Egor-G/router4x4g/README.md

4x M.2 LTE modems router project.
Based on Myirtech MYC-Y6ULX SoM.
Supply volatage 12-24V.
Openwrt OS.
