Egor-G/router4x4g/MCU_board/fab/Router_MCU_BOM.xlsx

Designator | Comment | Footprint
C1, | 22u | 0805
C2, C6, C9, C15, C16, C17, C22, | 0.1u | 0603
C3, C4, | 18p | 0603
C5, C7, | 4.7u | 1206
C8, C20, | 4.7u | 0603
C10, | 1n 2kV | 1206
C11, | 10u | 0805
C12, | 10n | 0603
C13, | 470p | 0603
C14, | 8.2p | 0603
C18, C19, C21, | 47u | 1206
C23, | 100u 50V | 10x10.5
D1, | DB107S
D2, | TVS | SMA
D3, | 3mm
D4, | SS540 | SMA
FB1, | 2A | 0805
J1, | Header
L1, | 15uH
R1, R25, | 1k | 0603
R2, R23, R24, | 470R | 0603
R3, R4, | 100R | 0603
R5, R6, R7, R8, R9, | 22R | 0603
R10, | 4.7k | 0603
R11, | 1.5k | 0603
R12, | 200k | 0603
R13, R14, | 75R | 0603
R15, | 18k | 0603
R16, R18, R21, R22, | 49.9R | 0603
R17, | 12k | 0603
R19, | 36k | 0603
R20, | 6.8k | 0603
T1, | HY601742
U1, | MYC-YT507H
U2, | TPS54340 | SO-8
U3, | LAN8720A | QFN-24
X1, X2, X3, X4, | B4B-XH
X5, | B2B-XH
X6, | TFP09-2-12B
X7, | RJ45
Y1, | 25MHz | 3.2x2.5mm
