Egor-G/router4x4g/Modems_board/fab/Router_Modems_BOM.xlsx

Designator | Comment | Footprint
C1, C11, C23, C30, | 1u | 0603
C2, C7, C13, C17, C25, C29, C31, C34, | 47u | 1206
C3, C5, C10, C15, C16, C22, C27, C28, C32, C33, | 0.1u | 0603
C4, C6, C18, C19, | 4.7u | 1206
C8, C20, | 910p | 0603
C9, C21, | 6.8p | 0603
C12, C14, C24, C26, C35, C36, | 100u | 3528
C37, | 100u 50V | 10x10.5
D1, D3, D5, D6, | LED
D2, D4, | SS510 | SMA
L1, L2, | 15uH
N1, N2, N3, N4, | SMTSO2515CTJ
R1, R5, R11, R15, | 2k | 0603
R2, R9, | 200k | 0603
R3, R8, R14, R16, | 470R | 0603
R4, R10, | 43k | 0603
R6, R12, | 47k | 0603
R7, R13, | 15k | 0603
U1, U3, U5, U6, | SRV05-4 | SOT-23-6
U2, U4, | TPS54540 | SO-8
X1, X4, X6, X10, | 7111S2015X02LF
X2, | B2B-XH
X3, X5, X7, X11, | AS0BC21-S30BB-7H
X8, X9, X12, X13, | B4B-XH
