Egor-G/router4x4g/AK-01-59.dxf

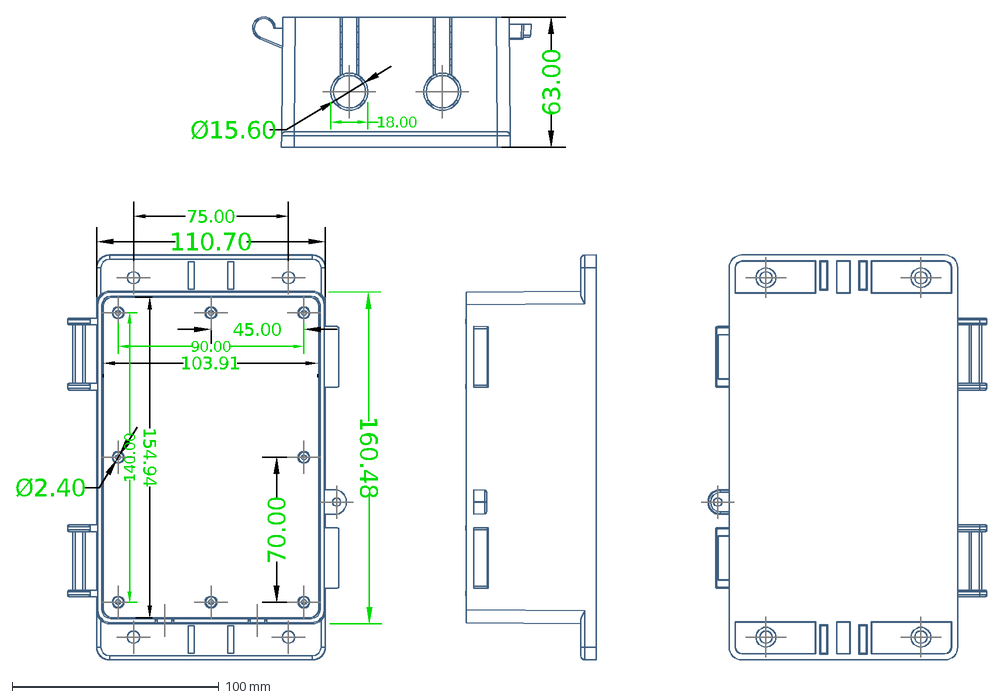
[picture p1: CAD file, 2023-02-11]
AK-01-59.dxf
75.00
103.91
154.94
45.00
160.48
110.70
Ø2.40
70.00
Ø15.60
63.00
90.00
140.00
18.00
