Egor-G/router4x4g/MCU_board/Router_MCU.kicad_pcb

## KiCad design MCU_board/Router_MCU.kicad_pcb (2023-03-17)

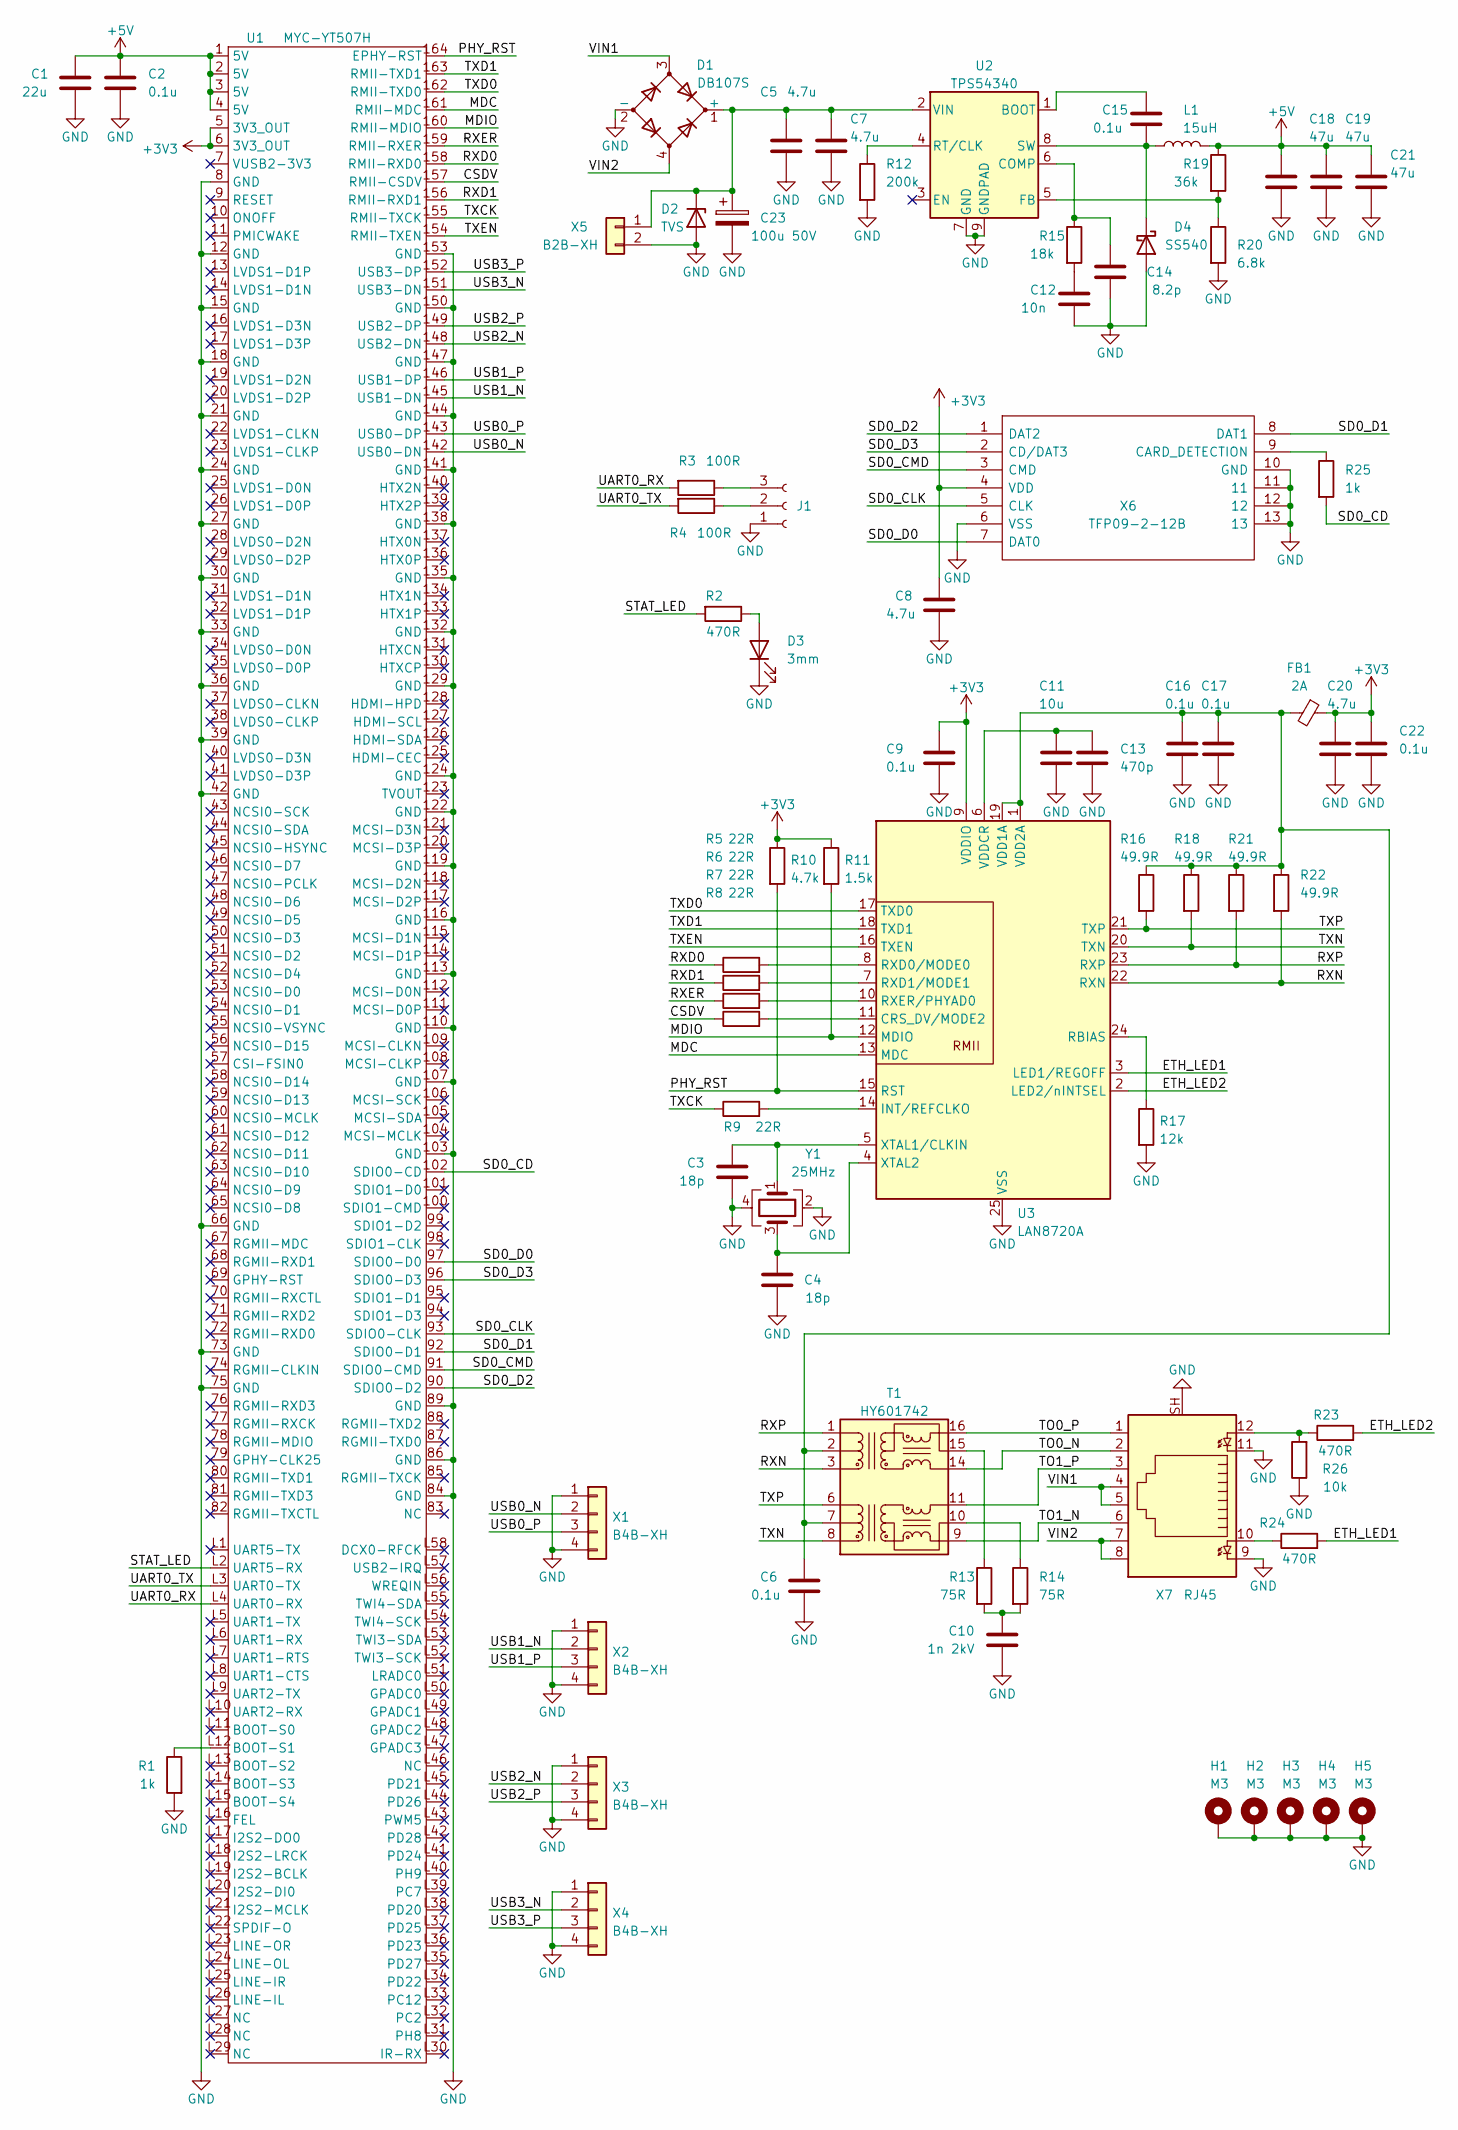
[picture p2: schematic Router_MCU.kicad_sch]

Parts:
C1: 22u; C_0805_2012Metric
C2, C6, C9, C15, C16, C17, C22: 0.1u; C_0603_1608Metric
C3, C4: 18p; C_0603_1608Metric
C5, C7: 4.7u; C_1206_3216Metric
C8, C20: 4.7u; C_0603_1608Metric
C10: 1n 2kV; C_1206_3216Metric
C11: 10u; C_0805_2012Metric
C12: 10n; C_0603_1608Metric
C13: 470p; C_0603_1608Metric
C14: 8.2p; C_0603_1608Metric
C18, C19, C21: 47u; C_1206_3216Metric
C23: 100u 50V; CP_Elec_10x10.5
D1: DB107S; Diode_Bridge_OnSemi_SDIP-4L
D2: TVS; D_SMA
D3: 3mm; LED_D3.0mm
D4: SS540; D_SMA
FB1: 2A; R_0805_2012Metric
H1, H2, H3, H4, H5: M3; MountingHole_3.5mm_Pad
J1: Header; PinHeader_1x03_P2.54mm_Vertical
L1: 15uH; L_Sunlord_MWSA1004S
R1, R25: 1k; R_0603_1608Metric
R2, R23, R24: 470R; R_0603_1608Metric
R3, R4: 100R; R_0603_1608Metric
R5, R6, R7, R8, R9: 22R; R_0603_1608Metric
R10: 4.7k; R_0603_1608Metric
R11: 1.5k; R_0603_1608Metric
R12: 200k; R_0603_1608Metric
R13, R14: 75R; R_0603_1608Metric
R15: 18k; R_0603_1608Metric
R16, R18, R21, R22: 49.9R; R_0603_1608Metric
R17: 12k; R_0603_1608Metric
R19: 36k; R_0603_1608Metric
R20: 6.8k; R_0603_1608Metric
R26: 10k; R_0603_1608Metric
T1: HY601742; Transformer_Ethernet_Bourns_PT61017PEL
U1: MYC-YT507H
U2: TPS54340; TI_SO-PowerPAD-8_ThermalVias
U3: LAN8720A; QFN-24-1EP_4x4mm_P0.5mm_EP2.6x2.6mm
X1, X2, X3, X4: B4B-XH; JST_XH_B4B-XH-A_1x04_P2.50mm_Vertical
X5: B2B-XH; JST_XH_B2B-XH-A_1x02_P2.50mm_Vertical
X6: TFP09-2-12B; TFP09212B; Manufacturer_Part_Number TFP09-2-12B
X7: RJ45; RJ45_Amphenol_RJHSE538X
Y1: 25MHz; Oscillator_SMD_Abracon_ASE-4Pin_3.2x2.5mm

Connections:
+3V3: C8.1, C9.1, C20.1, C22.1, FB1.1, R10.1, R11.1, U1.5 (3V3_OUT), U1.6 (3V3_OUT), U3.9 (VDDIO), X6.4 (VDD)
+5V: C1.1, C2.1, C18.1, C19.1, C21.1, L1.2, R19.1, U1.1 (5V), U1.2 (5V), U1.3 (5V), U1.4 (5V)
/CSDV: R8.1, U1.157 (RMII-CSDV)
/ETH_LED1: R24.2, U3.3 (LED1/REGOFF)
/ETH_LED2: R23.2, U3.2 (LED2/nINTSEL)
/MDC: U1.161 (RMII-MDC), U3.13 (MDC)
/MDIO: R11.2, U1.160 (RMII-MDIO), U3.12 (MDIO)
/PHY_RST: R10.2, U1.164 (EPHY-RST), U3.15 (RST)
/RXD0: R5.1, U1.158 (RMII-RXD0)
/RXD1: R6.1, U1.156 (RMII-RXD1)
/RXER: R7.1, U1.159 (RMII-RXER)
/RXN: R22.2, T1.3 (TD-), U3.22 (RXN)
/RXP: R21.2, T1.1 (TD+), U3.23 (RXP)
/SD0_CD: R25.2, U1.102 (SDIO0-CD)
/SD0_CLK: U1.93 (SDIO0-CLK), X6.5 (CLK)
/SD0_CMD: U1.91 (SDIO0-CMD), X6.3 (CMD)
/SD0_D0: U1.97 (SDIO0-D0), X6.7 (DAT0)
/SD0_D1: U1.92 (SDIO0-D1), X6.8 (DAT1)
/SD0_D2: U1.90 (SDIO0-D2), X6.1 (DAT2)
/SD0_D3: U1.96 (SDIO0-D3), X6.2 (CD/DAT3)
/STAT_LED: R2.2, U1.L2 (UART5-RX)
/TO0_N: T1.14 (TX-), X7.2
/TO0_P: T1.16 (TX+), X7.1
/TO1_N: T1.9 (RX-), X7.6
/TO1_P: T1.11 (RX+), X7.3
/TXCK: R9.1, U1.155 (RMII-TXCK)
/TXD0: U1.162 (RMII-TXD0), U3.17 (TXD0)
/TXD1: U1.163 (RMII-TXD1), U3.18 (TXD1)
/TXEN: U1.154 (RMII-TXEN), U3.16 (TXEN)
/TXN: R18.2, T1.8 (RD-), U3.20 (TXN)
/TXP: R16.2, T1.6 (RD+), U3.21 (TXP)
/UART0_RX: R3.2, U1.L4 (UART0-RX)
/UART0_TX: R4.2, U1.L3 (UART0-TX)
/USB0_N: U1.142 (USB0-DN), X1.2
/USB0_P: U1.143 (USB0-DP), X1.3
/USB1_N: U1.145 (USB1-DN), X2.2
/USB1_P: U1.146 (USB1-DP), X2.3
/USB2_N: U1.148 (USB2-DN), X3.2
/USB2_P: U1.149 (USB2-DP), X3.3
/USB3_N: U1.151 (USB3-DN), X4.2
/USB3_P: U1.152 (USB3-DP), X4.3
/VIN1: D1.3, X7.4, X7.5
/VIN2: D1.4, X7.7, X7.8
GND: C1.2, C2.2, C3.1, C4.1, C5.2, C6.2, C7.2, C8.2, C9.2, C10.1, C11.2, C12.2, C13.2, C14.1, C16.2, C17.2, C18.2, C19.2, C20.2, C21.2, C22.2, C23.2, D1.2 (-), D2.2 (A), D3.1 (K), D4.2 (A), H1.1, H2.1, H3.1, H4.1, H5.1, J1.1, R1.2, R12.2, R17.2, R20.2, R26.1, U1.8 (GND), U1.12 (GND), U1.15 (GND), U1.18 (GND), U1.21 (GND), U1.24 (GND), U1.27 (GND), U1.30 (GND), U1.33 (GND), U1.36 (GND), U1.39 (GND), U1.42 (GND), U1.66 (GND), U1.73 (GND), U1.75 (GND), U1.84 (GND), U1.86 (GND), U1.89 (GND), U1.103 (GND), U1.107 (GND), U1.110 (GND), U1.113 (GND), U1.116 (GND), U1.119 (GND), U1.122 (GND), U1.124 (GND), U1.129 (GND), U1.132 (GND), U1.135 (GND), U1.138 (GND), U1.141 (GND), U1.144 (GND), U1.147 (GND), U1.150 (GND), U1.153 (GND), U2.7 (GND), U2.9 (GNDPAD), U3.25 (VSS), X1.1, X1.4, X2.1, X2.4, X3.1, X3.4, X4.1, X4.4, X5.2, X6.6 (VSS), X6.10 (GND), X6.11, X6.12, X6.13, X7.9, X7.11, X7.SH, Y1.2, Y1.4
unnamed: C3.2, U3.5 (XTAL1/CLKIN), Y1.1
unnamed: C4.2, U3.4 (XTAL2), Y1.3
unnamed: C10.2, R13.2, R14.2
unnamed: C11.1, C13.1, U3.6 (VDDCR)
unnamed: C12.1, R15.2
unnamed: C14.2, R15.1, U2.6 (COMP)
unnamed: C15.1, U2.1 (BOOT)
unnamed: C15.2, D4.1 (K), L1.1, U2.8 (SW)
unnamed: C6.1, C16.1, C17.1, FB1.2, R16.1, R18.1, R21.1, R22.1, T1.2 (C_TD), T1.7 (C_RD), U3.1 (VDD2A), U3.19 (VDD1A)
unnamed: C5.1, C7.1, C23.1, D1.1 (+), D2.1 (K), U2.2 (VIN), X5.1
unnamed: D3.2 (A), R2.1
unnamed: J1.2, R4.1
unnamed: J1.3, R3.1
unnamed: R1.1, U1.L12 (BOOT-S1)
unnamed: R5.2, U3.8 (RXD0/MODE0)
unnamed: R6.2, U3.7 (RXD1/MODE1)
unnamed: R7.2, U3.10 (RXER/PHYAD0)
unnamed: R8.2, U3.11 (CRS_DV/MODE2)
unnamed: R9.2, U3.14 (INT/REFCLKO)
unnamed: R12.1, U2.4 (RT/CLK)
unnamed: R13.1, T1.15 (C_TX)
unnamed: R14.1, T1.10 (C_RX)
unnamed: R17.1, U3.24 (RBIAS)
unnamed: R19.2, R20.1, U2.5 (FB)
unnamed: R23.1, R26.2, X7.12
unnamed: R24.1, X7.10
unnamed: R25.1, X6.9 (CARD_DETECTION)

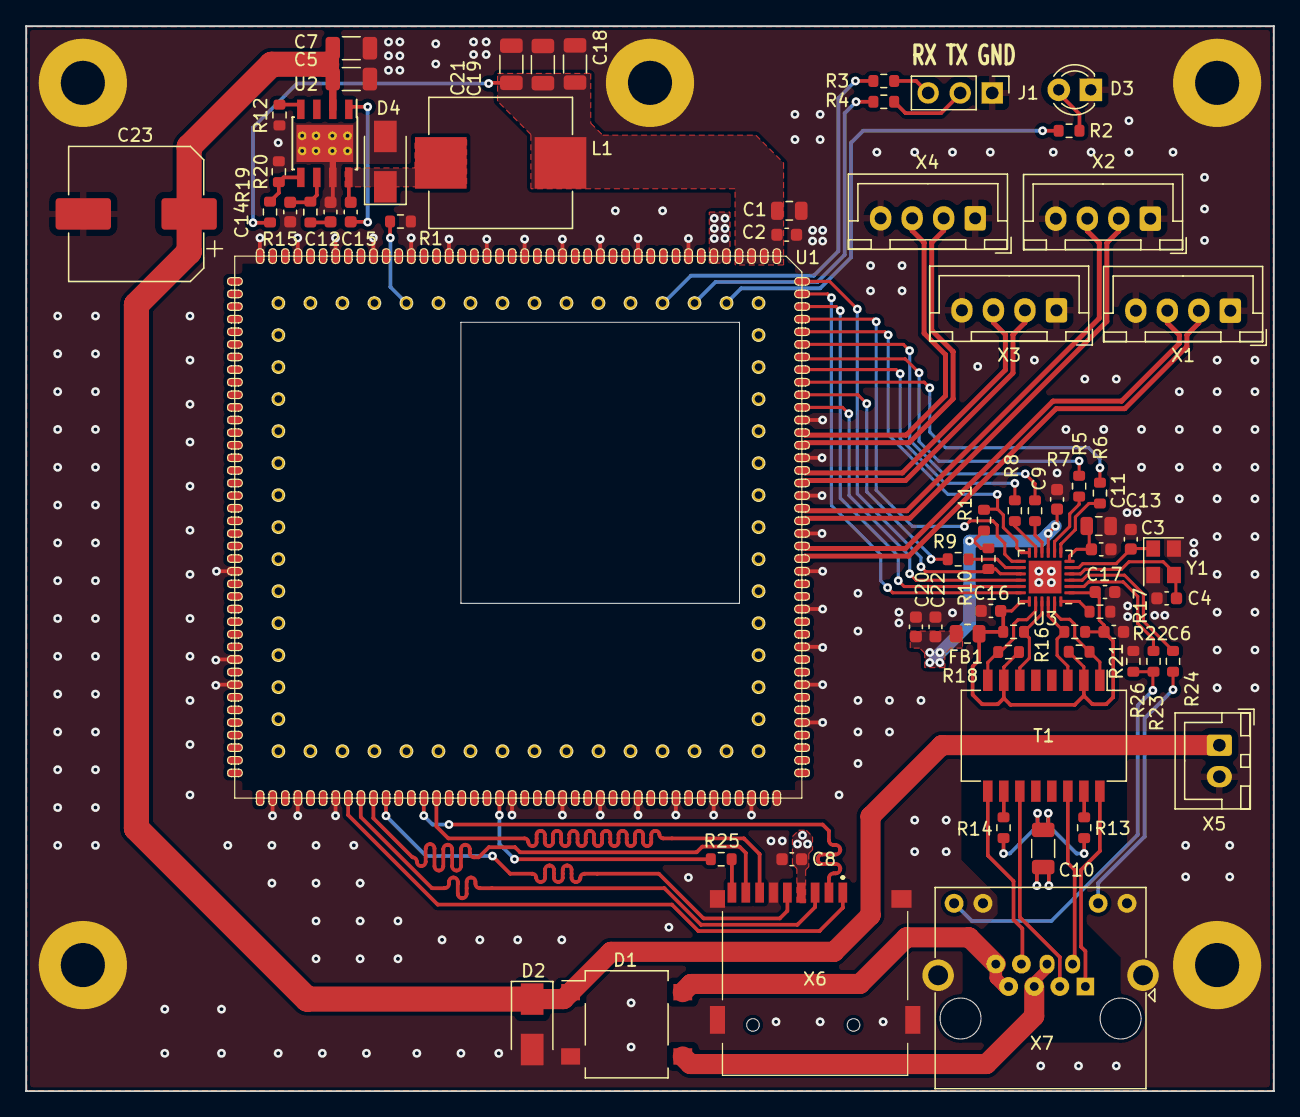
[picture p3: board Router_MCU.kicad_pcb from above]

Board: 2 copper layers, 99.0 x 84.5 mm, 73 parts (0 on the bottom side), 71 nets.
