Egor-G/router4x4g/Modems_board/Router_Modems.kicad_pcb

## KiCad design Modems_board/Router_Modems.kicad_pcb (2023-03-09)

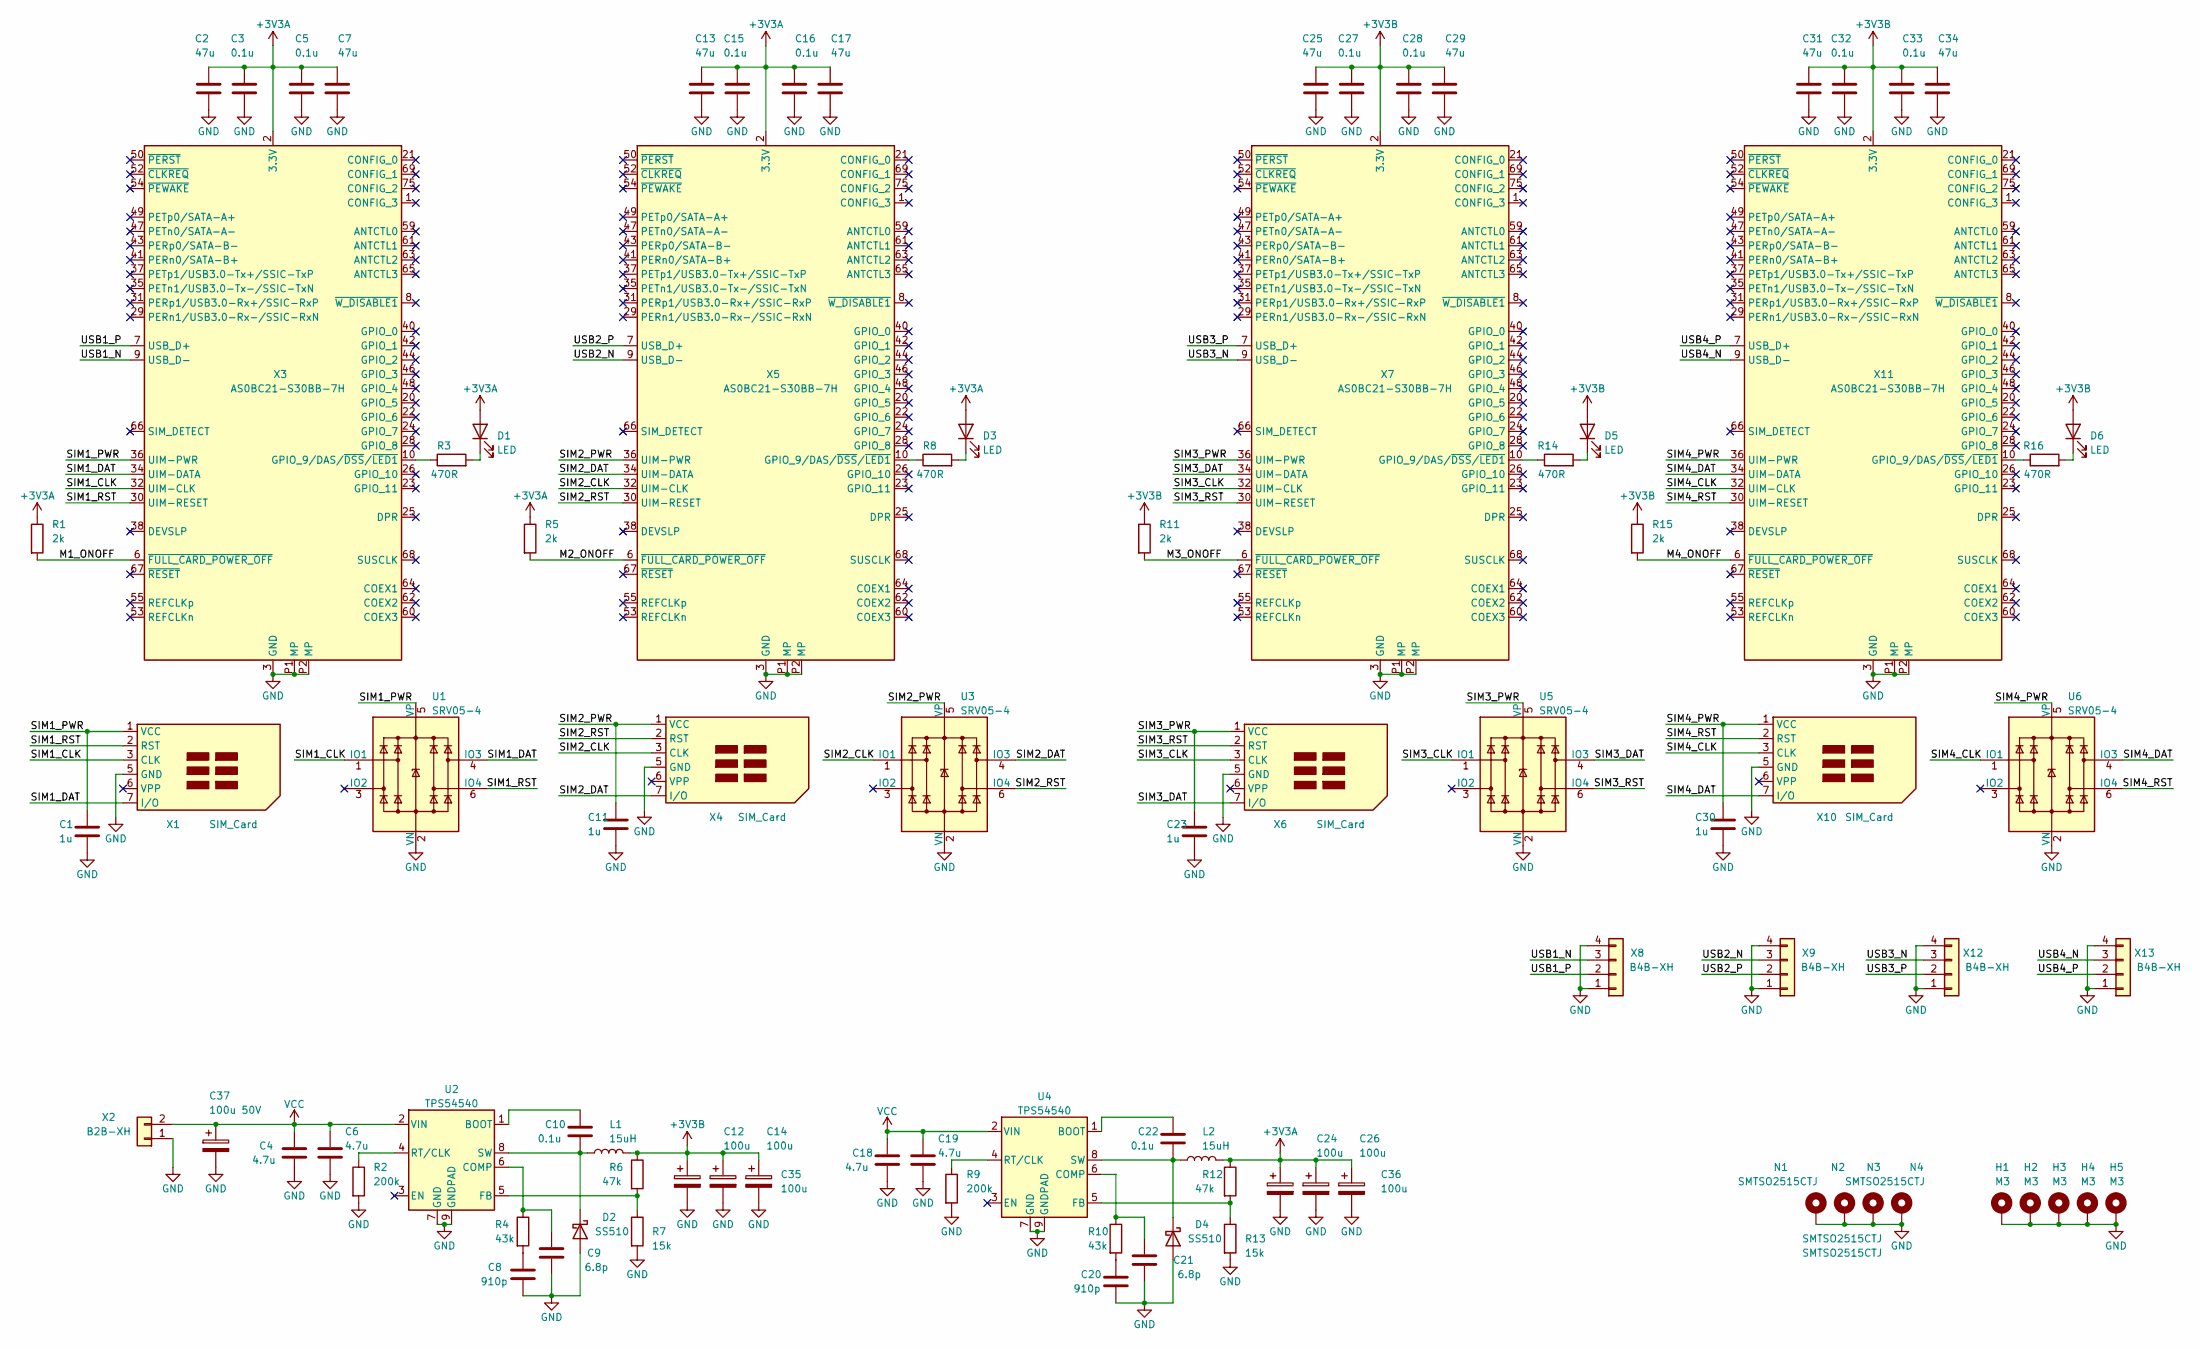
[picture p4: schematic Router_Modems.kicad_sch]

Parts:
C1, C11, C23, C30: 1u; C_0603_1608Metric
C2, C7, C13, C17, C25, C29, C31, C34: 47u; C_1206_3216Metric
C3, C5, C10, C15, C16, C22, C27, C28, C32, C33: 0.1u; C_0603_1608Metric
C4, C6, C18, C19: 4.7u; C_1206_3216Metric
C8, C20: 910p; C_0603_1608Metric
C9, C21: 6.8p; C_0603_1608Metric
C12, C14, C24, C26, C35, C36: 100u; CP_EIA-3528-15_AVX-H
C37: 100u 50V; CP_Elec_10x10.5
D1, D3, D5, D6: LED; LED_D3.0mm
D2, D4: SS510; D_SMA
H1, H2, H3, H4, H5: M3; MountingHole_3.5mm_Pad
L1, L2: 15uH; L_Sunlord_MWSA1004S
N1, N2, N3, N4: SMTSO2515CTJ; MountingHole_3.2mm_M3_Pad
R1, R5, R11, R15: 2k; R_0603_1608Metric
R2, R9: 200k; R_0603_1608Metric
R3, R8, R14, R16: 470R; R_0603_1608Metric
R4, R10: 43k; R_0603_1608Metric
R6, R12: 47k; R_0603_1608Metric
R7, R13: 15k; R_0603_1608Metric
U1, U3, U5, U6: SRV05-4; SOT-23-6
U2, U4: TPS54540; TI_SO-PowerPAD-8_ThermalVias
X1, X4, X6, X10: SIM_Card; FCI_7111S2015X02LF
X2: B2B-XH; JST_XH_B2B-XH-A_1x02_P2.50mm_Vertical
X3, X5, X7, X11: AS0BC21-S30BB-7H; AMPHENOL_MDT420B03001
X8, X9, X12, X13: B4B-XH; JST_XH_B4B-XH-A_1x04_P2.50mm_Vertical

Connections:
+3V3A: C2.1, C3.1, C5.1, C7.1, C13.1, C15.1, C16.1, C17.1, C24.1, C26.1, C36.1, D1.2 (A), D3.2 (A), L2.2, R1.1, R5.1, R12.1, X3.2 (3.3V), X3.4 (3.3V), X3.70 (3.3V), X3.72 (3.3V), X3.74 (3.3V), X5.2 (3.3V), X5.4 (3.3V), X5.70 (3.3V), X5.72 (3.3V), X5.74 (3.3V)
+3V3B: C12.1, C14.1, C25.1, C27.1, C28.1, C29.1, C31.1, C32.1, C33.1, C34.1, C35.1, D5.2 (A), D6.2 (A), L1.2, R6.1, R11.1, R15.1, X7.2 (3.3V), X7.4 (3.3V), X7.70 (3.3V), X7.72 (3.3V), X7.74 (3.3V), X11.2 (3.3V), X11.4 (3.3V), X11.70 (3.3V), X11.72 (3.3V), X11.74 (3.3V)
/M1_ONOFF: R1.2, X3.6 (~FULL_CARD_POWER_OFF)
/M2_ONOFF: R5.2, X5.6 (~FULL_CARD_POWER_OFF)
/M3_ONOFF: R11.2, X7.6 (~FULL_CARD_POWER_OFF)
/M4_ONOFF: R15.2, X11.6 (~FULL_CARD_POWER_OFF)
/SIM1_CLK: U1.1 (IO1), X1.3 (CLK), X3.32 (UIM-CLK)
/SIM1_DAT: U1.4 (IO3), X1.7 (I/O), X3.34 (UIM-DATA)
/SIM1_PWR: C1.1, U1.5 (VP), X1.1 (VCC), X3.36 (UIM-PWR)
/SIM1_RST: U1.6 (IO4), X1.2 (RST), X3.30 (UIM-RESET)
/SIM2_CLK: U3.1 (IO1), X4.3 (CLK), X5.32 (UIM-CLK)
/SIM2_DAT: U3.4 (IO3), X4.7 (I/O), X5.34 (UIM-DATA)
/SIM2_PWR: C11.1, U3.5 (VP), X4.1 (VCC), X5.36 (UIM-PWR)
/SIM2_RST: U3.6 (IO4), X4.2 (RST), X5.30 (UIM-RESET)
/SIM3_CLK: U5.1 (IO1), X6.3 (CLK), X7.32 (UIM-CLK)
/SIM3_DAT: U5.4 (IO3), X6.7 (I/O), X7.34 (UIM-DATA)
/SIM3_PWR: C23.1, U5.5 (VP), X6.1 (VCC), X7.36 (UIM-PWR)
/SIM3_RST: U5.6 (IO4), X6.2 (RST), X7.30 (UIM-RESET)
/SIM4_CLK: U6.1 (IO1), X10.3 (CLK), X11.32 (UIM-CLK)
/SIM4_DAT: U6.4 (IO3), X10.7 (I/O), X11.34 (UIM-DATA)
/SIM4_PWR: C30.1, U6.5 (VP), X10.1 (VCC), X11.36 (UIM-PWR)
/SIM4_RST: U6.6 (IO4), X10.2 (RST), X11.30 (UIM-RESET)
/USB1_N: X3.9 (USB_D-), X8.3
/USB1_P: X3.7 (USB_D+), X8.2
/USB2_N: X5.9 (USB_D-), X9.3
/USB2_P: X5.7 (USB_D+), X9.2
/USB3_N: X7.9 (USB_D-), X12.3
/USB3_P: X7.7 (USB_D+), X12.2
/USB4_N: X11.9 (USB_D-), X13.3
/USB4_P: X11.7 (USB_D+), X13.2
GND: C1.2, C2.2, C3.2, C4.2, C5.2, C6.2, C7.2, C8.2, C9.1, C11.2, C12.2, C13.2, C14.2, C15.2, C16.2, C17.2, C18.2, C19.2, C20.2, C21.1, C23.2, C24.2, C25.2, C26.2, C27.2, C28.2, C29.2, C30.2, C31.2, C32.2, C33.2, C34.2, C35.2, C36.2, C37.2, D2.2 (A), D4.2 (A), H1.1, H2.1, H3.1, H4.1, H5.1, N1.1, N2.1, N3.1, N4.1, R2.2, R7.2, R9.2, R13.2, U1.2 (VN), U2.7 (GND), U2.9 (GNDPAD), U3.2 (VN), U4.7 (GND), U4.9 (GNDPAD), U5.2 (VN), U6.2 (VN), X1.5 (GND), X2.1, X3.3 (GND), X3.5 (GND), X3.11 (GND), X3.27 (GND), X3.33 (GND), X3.39 (GND), X3.45 (GND), X3.51 (GND), X3.57 (GND), X3.71 (GND), X3.73 (GND), X3.P1 (MP), X3.P2 (MP), X4.5 (GND), X5.3 (GND), X5.5 (GND), X5.11 (GND), X5.27 (GND), X5.33 (GND), X5.39 (GND), X5.45 (GND), X5.51 (GND), X5.57 (GND), X5.71 (GND), X5.73 (GND), X5.P1 (MP), X5.P2 (MP), X6.5 (GND), X7.3 (GND), X7.5 (GND), X7.11 (GND), X7.27 (GND), X7.33 (GND), X7.39 (GND), X7.45 (GND), X7.51 (GND), X7.57 (GND), X7.71 (GND), X7.73 (GND), X7.P1 (MP), X7.P2 (MP), X8.1, X8.4, X9.1, X9.4, X10.5 (GND), X11.3 (GND), X11.5 (GND), X11.11 (GND), X11.27 (GND), X11.33 (GND), X11.39 (GND), X11.45 (GND), X11.51 (GND), X11.57 (GND), X11.71 (GND), X11.73 (GND), X11.P1 (MP), X11.P2 (MP), X12.1, X12.4, X13.1, X13.4
unnamed: C8.1, R4.2
unnamed: C9.2, R4.1, U2.6 (COMP)
unnamed: C10.1, U2.1 (BOOT)
unnamed: C10.2, D2.1 (K), L1.1, U2.8 (SW)
unnamed: C20.1, R10.2
unnamed: C21.2, R10.1, U4.6 (COMP)
unnamed: C22.1, U4.1 (BOOT)
unnamed: C22.2, D4.1 (K), L2.1, U4.8 (SW)
unnamed: D1.1 (K), R3.2
unnamed: D3.1 (K), R8.2
unnamed: D5.1 (K), R14.2
unnamed: D6.1 (K), R16.2
unnamed: R2.1, U2.4 (RT/CLK)
unnamed: R3.1, X3.10 (GPIO_9/DAS/~DSS/~LED1)
unnamed: R6.2, R7.1, U2.5 (FB)
unnamed: R8.1, X5.10 (GPIO_9/DAS/~DSS/~LED1)
unnamed: R9.1, U4.4 (RT/CLK)
unnamed: R12.2, R13.1, U4.5 (FB)
unnamed: R14.1, X7.10 (GPIO_9/DAS/~DSS/~LED1)
unnamed: R16.1, X11.10 (GPIO_9/DAS/~DSS/~LED1)
VCC: C4.1, C6.1, C18.1, C19.1, C37.1, U2.2 (VIN), U4.2 (VIN), X2.2

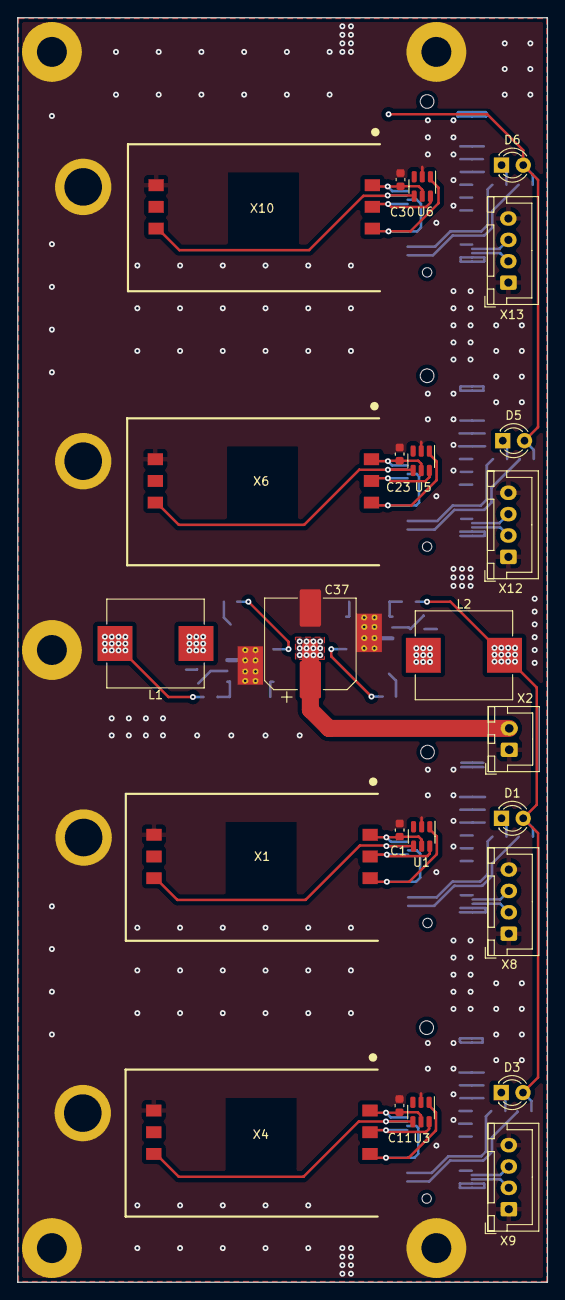
[picture p5: board Router_Modems.kicad_pcb from above]

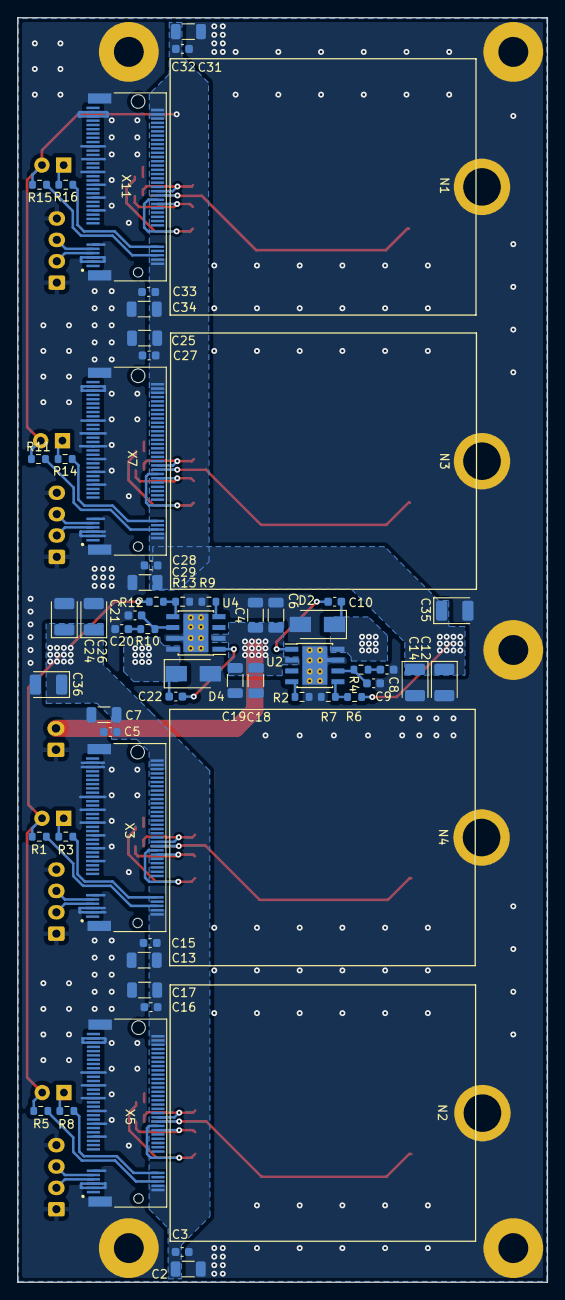
[picture p6: board Router_Modems.kicad_pcb from below]

Board: 2 copper layers, 62.0 x 148.0 mm, 89 parts (60 on the bottom side), 52 nets.
