Egor-G/router4x4g/(commit log)

2022-12-26 Move to YT507 module, split boards
    [4x4g_modems.kicad_sch, 4x4g_modems_2.kicad_sch, 4x4g_power.kicad_sch, Router_MCU.kicad_pcb, Router_MCU.kicad_sch, Router_Modems.kicad_pcb, Router_Modems.kicad_sch, router4x4g.kicad_sch]
2023-02-11 routing procs
    [AK-01-59.dxf, Router_MCU.kicad_pcb, Router_MCU.kicad_sch, Router_Modems.kicad_pcb, Router_Modems.kicad_sch]
2023-02-14 Modems board ready
    [Router_MCU.kicad_pcb, Router_MCU.kicad_sch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]
2023-02-15 Ready for order
    [Router_MCU-B_Cu.gbl, Router_MCU-B_Mask.gbs, Router_MCU-B_Silkscreen.gbo, Router_MCU-Edge_Cuts.gm1, Router_MCU-F_Cu.gtl, Router_MCU-F_Mask.gts, Router_MCU-F_Silkscreen.gto, Router_MCU-NPTH.drl]
2023-03-09 remove modems gpio ctrls
    [Router_MCU-B_Cu.gbl, Router_MCU-B_Mask.gbs, Router_MCU-B_Silkscreen.gbo, Router_MCU-Edge_Cuts.gm1, Router_MCU-F_Cu.gtl, Router_MCU-F_Mask.gts, Router_MCU-F_Silkscreen.gto, Router_MCU-NPTH.drl]
2023-03-17 lan8720 led config resistor
    [Router_MCU-B_Cu.gbl, Router_MCU-B_Mask.gbs, Router_MCU-B_Silkscreen.gbo, Router_MCU-Edge_Cuts.gm1, Router_MCU-F_Cu.gtl, Router_MCU-F_Mask.gts, Router_MCU-F_Silkscreen.gto, Router_MCU-NPTH.drl]
